ElektronikaDonBosco/Topollution/(list of files, drawings)

Other design files:
LoRa.pdsprj
SIM 808 pcb.pdsprj
